OpenDrone-hw/OpenRX/images/openrx-gemini-back.png

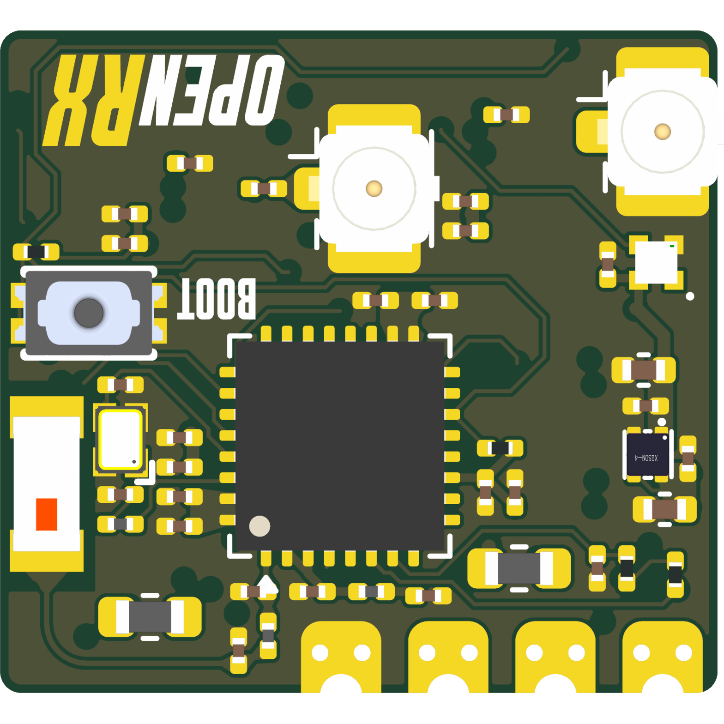
images/openrx-gemini-back.png
