OpenDrone-hw/OpenRX/images/openrx-lite-back.png

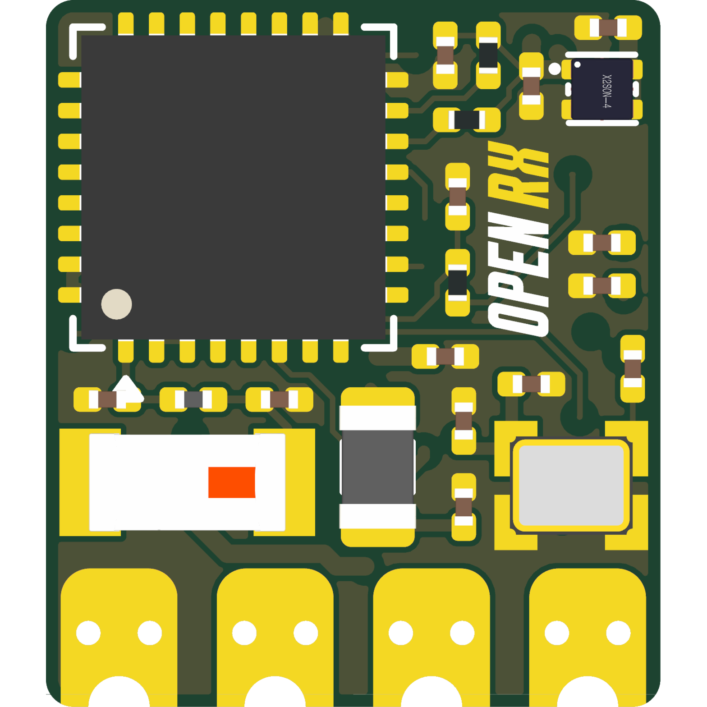
images/openrx-lite-back.png
