OpenDrone-hw/OpenRX/images/openrx-mono-back.png

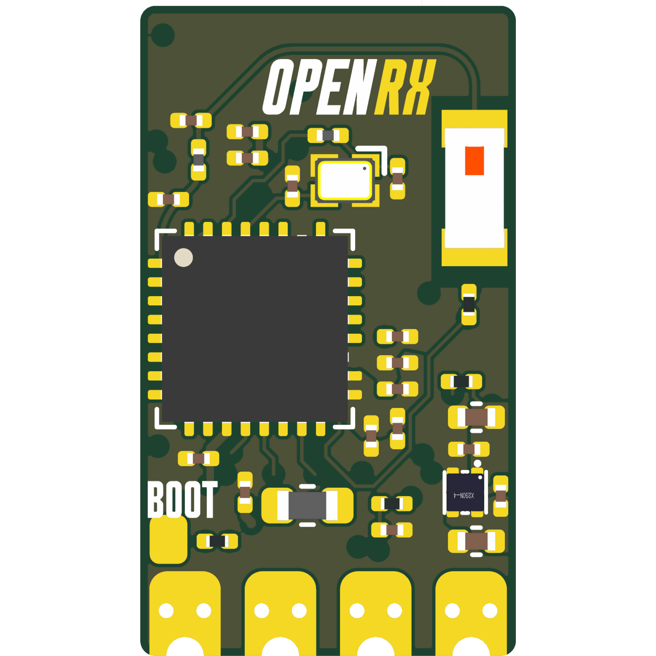
images/openrx-mono-back.png
