OpenDrone-hw/OpenRX/panel/OpenRX-panel-rev2.kicad_pcb

## KiCad design panel/OpenRX-panel-rev2.kicad_pcb (2026-09-19)

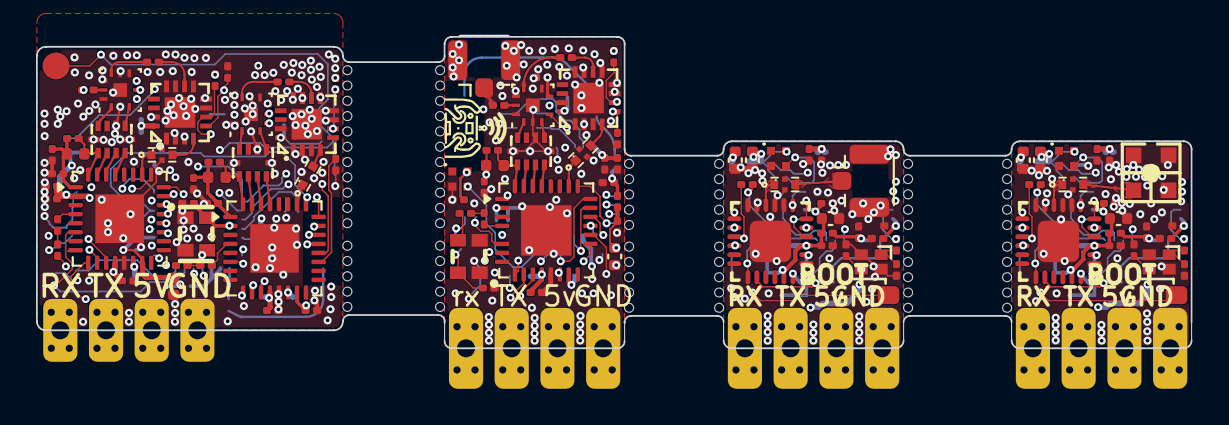
[picture p8: board OpenRX-panel-rev2.kicad_pcb from above]

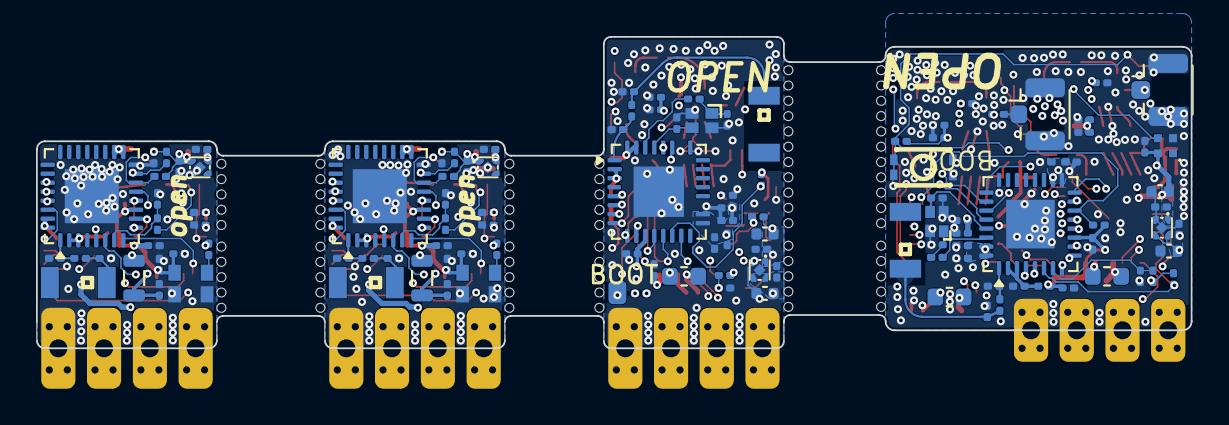
[picture p9: board OpenRX-panel-rev2.kicad_pcb from below]

Board: 6 copper layers, 64.2 x 17.3 mm, 241 parts (118 on the bottom side), 103 nets.

Parts:
AE1, AE101, AE201, AE301: 2450AT18A100E; ANT-SMD_L3.2-W1.6
AE302: 47948-0001; ANT-SMD_47948-0001
C1, C3, C101, C103, C201, C203, C301, C303: 15pF; C_0201_0603Metric
C2, C23, C24, C39, C42, C44, C102, C123, C124: 47p; C_0201_0603Metric
C4, C10, C17, C25, C27, C28, C31, C41, C104, C110, C117, C125, C127, C128, C131, C204, C210, C215, C223, C225, C228, C304, C310, C315, C323, C325, C328: 1uF; C_0201_0603Metric
C5, C6, C9, C12, C13, C14, C16, C35, C37, C105, C106, C109, C112, C113, C114, C116, C205, C206, C209, C212, C213, C214, C217, C305, C306, C309, C312, C313, C314, C317: 100nF; C_0201_0603Metric
C7, C34, C107: 10pF; C_0201_0603Metric
C8, C11, C18, C108, C111, C118, C208, C211, C216, C308, C311, C316: 10uF; C_0402_1005Metric
C15, C36, C115: 47pF; C_0201_0603Metric
C19, C33, C119: 2.2nF; C_0201_0603Metric
C20, C38, C120, C220, C320: 470nF; C_0201_0603Metric
C21, C40, C121: 220pF; C_0201_0603Metric
C22, C43, C122: 1n; C_0201_0603Metric
C26, C126, C224, C226, C227, C324, C326, C327: 10nF; C_0201_0603Metric
C29, C30, C129, C130, C221, C222, C321, C322: 1.2pF; C_0201_0603Metric
C219, C319: 1nF; C_0201_0603Metric
D1, D101, D201, D301: XL-1010RGBC-WS2812B; LED-SMD_4P-L1.0-W1.0-TL_XL-1010RGBC-WS2812B
FL1, FL2, FL101, FL201, FL301: 2450FM07D0034T; FILTER-SMD_4P-L1.0-W0.5-L
J1, J2, J101: Conn_Coaxial_Small; U.FL_Hirose_U.FL-R-SMT-1_Vertical
J201: Conn_Coaxial; U.FL_Hirose_U.FL-R-SMT-1_Vertical
L1, L6, L101: 10uH; L_0603_1608Metric
L2, L102, L201, L301: 24nH; L_0201_0603Metric
L3, L103, L203, L303: 2.0nH; L_0201_0603Metric
L4, L104, L202, L302: 2.5nH; L_0201_0603Metric
L5, L7, L105: 47nH; L_0402_1005Metric
L204, L304: 15uH; L_0805_2012Metric
OSC1, OSC101: OW7EL89CENUYO3YLC-32M; OSC-SMD_4P-L2.0-W1.6-BL_TXC_7Z
OSC201, OSC301: OW7EL89CENUNFAYLC-52M; OSC-SMD_4P-L2.0-W1.6-BL_TXC_7Z
R1, R10, R101: 200; R_0201_0603Metric
R2, R3, R4, R5, R102, R103, R104, R105, R202, R203, R204, R205, R302, R303, R304, R305: 10k; R_0201_0603Metric
R6, R9, R106: 220; R_0201_0603Metric
R7, R8, R11, R12, R107, R108: 100k; R_0201_0603Metric
T1, T2, T101: 0900PC16J0042001E; FILTER-SMD_10P-L2.0-W1.6-BL
TP1, TP101, TP201, TP301: RX; SolderPad_1.2x2.0mm
TP2, TP102, TP202, TP302: TX; SolderPad_1.2x2.0mm
TP3, TP103, TP203, TP303: 5V; SolderPad_1.2x2.0mm
TP4, TP104, TP204, TP304: GND; SolderPad_1.2x2.0mm
TP5: TestPoint; TestPoint_Pad_D1.5mm
TP105, TP205, TP305: BOOT; SolderPad_1.2x2.0mm
U1, U101, U201, U301: ESP32-C3; QFN-32-1EP_5x5mm_P0.5mm_EP3.7x3.7mm
U2, U102, U202, U302: TLV75533PDQNR; X2SON-4_L1.0-W1.0-P0.65-TL-EP
U3, U6, U103: LR1121IMLTRT; QFN-32-1EP_5x5mm_P0.5mm_EP3.7x3.7mm
U4, U7, U104: RFX2401C; QFN-16_L3.0-W3.0-P0.50-BL-EP1.7
U5, U8, U105: SKY13373-460LF; QFN-12_EP_2x2_Pitch0.5mm
U9: TS2306A 240GF MSM 9_C2976675; SW-SMD_4P-L3.0-W2.0-P0.85-LS3.5
U203, U303: SX1281IMLTRT; QFN-24_L4.0-W4.0-P0.50-TL-EP2.6
X1, X101, X201, X301: CJ17-400001010B20; CRYSTAL-SMD_4P-L1.6-W1.2-BL

Connections:
+3V3: C4.1, C5.1, C6.1, C9.1, C11.1, C12.1, C13.2, C14.1, C15.1, C16.1, C17.1, C18.1, C21.1, C22.1, C26.1, C27.1, C31.1, C35.1, C36.1, C37.1, C40.1, C41.1, C43.1, C104.1, C105.1, C106.1, C109.1, C111.1, C112.1, C113.2, C114.1, C115.1, C116.1, C117.1, C118.1, C121.1, C122.1, C126.1, C127.1, C131.1, C204.1, C205.1, C206.1, C209.1, C211.1, C212.1, C213.1, C214.1, C215.1, C216.1, C217.1, C223.1, C224.1, C304.1, C305.1, C306.1, C309.1, C311.1, C312.1, C313.1, C314.1, C315.1, C316.1, C317.1, C323.1, C324.1, D1.2 (VDD), D101.2 (VDD), D201.2 (VDD), D301.2 (VDD), L3.2, L103.2, L203.2, L303.2, OSC1.4 (VDD), OSC101.4 (VDD), OSC201.4 (VDD), OSC301.4 (VDD), R2.1, R3.1, R4.1, R5.2, R8.1, R12.1, R102.1, R103.1, R104.1, R105.2, R108.1, R202.1, R203.1, R204.1, R205.2, R302.1, R303.1, R304.1, R305.2, U1.11 (VDD3P3_RTC), U1.17 (VDD3P3_CPU), U1.18 (VDD_SPI), U1.31 (VDDA), U1.32 (VDDA), U2.1 (OUT), U3.2 (VBAT_RF), U3.15 (VBAT), U4.16 (VDD), U5.6 (VDD), U6.2 (VBAT_RF), U6.15 (VBAT), U7.16 (VDD), U8.6 (VDD), U101.11 (VDD3P3_RTC), U101.17 (VDD3P3_CPU), U101.18 (VDD_SPI), U101.31 (VDDA), U101.32 (VDDA), U102.1 (OUT), U103.2 (VBAT_RF), U103.15 (VBAT), U104.16 (VDD), U105.6 (VDD), U201.11 (VDD3P3_RTC), U201.17 (VDD3P3_CPU), U201.18 (VDD_SPI), U201.31 (VDDA), U201.32 (VDDA), U202.1 (OUT), U203.11 (VBAT_IO), U203.15 (VBAT), U301.11 (VDD3P3_RTC), U301.17 (VDD3P3_CPU), U301.18 (VDD_SPI), U301.31 (VDDA), U301.32 (VDDA), U302.1 (OUT), U303.11 (VBAT_IO), U303.15 (VBAT)
+5V: C8.1, C10.1, C108.1, C110.1, C208.1, C210.1, C308.1, C310.1, TP3.1 (1_1), TP103.1 (1_1), TP203.1 (1_1), TP303.1 (1_1), U2.3 (EN), U2.4 (IN), U102.3 (EN), U102.4 (IN), U202.3 (EN), U202.4 (IN), U302.3 (EN), U302.4 (IN)
/Clock/TCXO_Out: C7.2, C34.2, OSC1.3 (OutPut)
/ESP32-C3 + LR1121 Mono/BOOT: R104.2, TP105.1 (1_1), U101.15 (GPIO9)
/ESP32-C3 + LR1121 Mono/BUSY: U101.8 (GPIO3), U103.25 (DIO0/BUSY)
/ESP32-C3 + LR1121 Mono/CHIP_EN: C128.1, R105.1, U101.7 (CHIP_EN)
/ESP32-C3 + LR1121 Mono/CTRL1: U103.11 (DIO7), U105.4 (V1)
/ESP32-C3 + LR1121 Mono/CTRL2: U103.10 (DIO8), U105.5 (V2)
/ESP32-C3 + LR1121 Mono/DIO1: U101.5 (XTAL_32K_N), U103.9 (DIO9)
/ESP32-C3 + LR1121 Mono/LED: D101.4 (DIN), R103.2, U101.14 (GPIO8)
/ESP32-C3 + LR1121 Mono/MISO: U101.10 (MTDI), U103.21 (DIO4)
/ESP32-C3 + LR1121 Mono/MOSI: U101.9 (MTMS), U103.22 (DIO3)
/ESP32-C3 + LR1121 Mono/NSS: U101.13 (MTDO), U103.24 (DIO1)
/ESP32-C3 + LR1121 Mono/RST: R102.2, U101.6 (GPIO2), U103.6 (NRESET)
/ESP32-C3 + LR1121 Mono/RXEN24: R108.2, U103.20 (DIO5), U104.6 (RXEN)
/ESP32-C3 + LR1121 Mono/SCK: U101.12 (MTCK), U103.23 (DIO2)
/ESP32-C3 + LR1121 Mono/TXEN24: R107.2, U103.19 (DIO6), U104.5 (TXEN)
/ESP32-C3 + LR1121 Mono/VR_PA: C102.1, C119.1, L105.1, R101.1, U103.1 (VR_PA)
/ESP32-C3 + LR1121 Mono/WIFI: AE101.1, C130.1, L104.1
/ESP32-C3 + LR1121 Mono/XTAL_N: C103.1, U101.29 (XTAL_N), X101.3
/ESP32-C3 + LR1121 Mono/XTAL_P: L102.2, U101.30 (XTAL_P)
/ESP32-C3 + SX1281 Core (UFL)/BOOT: R204.2, R304.2, TP205.1 (1_1), TP305.1 (1_1), U201.15 (GPIO9), U301.15 (GPIO9)
/ESP32-C3 + SX1281 Core (UFL)/BUSY: U201.8 (GPIO3), U203.7 (BUSY), U301.8 (GPIO3), U303.7 (BUSY)
/ESP32-C3 + SX1281 Core (UFL)/CHIP_EN: C228.1, C328.1, R205.1, R305.1, U201.7 (CHIP_EN), U301.7 (CHIP_EN)
/ESP32-C3 + SX1281 Core (UFL)/DIO1: U201.5 (XTAL_32K_N), U203.8 (DIO1), U301.5 (XTAL_32K_N), U303.8 (DIO1)
/ESP32-C3 + SX1281 Core (UFL)/LED: D201.4 (DIN), D301.4 (DIN), R203.2, R303.2, U201.14 (GPIO8), U301.14 (GPIO8)
/ESP32-C3 + SX1281 Core (UFL)/MISO: U201.10 (MTDI), U203.16 (MISO_TX), U301.10 (MTDI), U303.16 (MISO_TX)
/ESP32-C3 + SX1281 Core (UFL)/MOSI: U201.9 (MTMS), U203.17 (MOSI_RX), U301.9 (MTMS), U303.17 (MOSI_RX)
/ESP32-C3 + SX1281 Core (UFL)/NSS: U201.13 (MTDO), U203.19 (NSS_CTS), U301.13 (MTDO), U303.19 (NSS_CTS)
/ESP32-C3 + SX1281 Core (UFL)/RST: R202.2, R302.2, U201.6 (GPIO2), U203.3 (NRESET), U301.6 (GPIO2), U303.3 (NRESET)
/ESP32-C3 + SX1281 Core (UFL)/SCK: U201.12 (MTCK), U203.18 (SCK_RTSN), U301.12 (MTCK), U303.18 (SCK_RTSN)
/ESP32-C3 + SX1281 Core (UFL)/WIFI: AE201.1, AE301.1, C221.1, C321.1, L202.1, L302.1
/ESP32-C3 + SX1281 Core (UFL)/XTAL_N: C203.1, C303.1, U201.29 (XTAL_N), U301.29 (XTAL_N), X201.3, X301.3
/ESP32-C3 + SX1281 Core (UFL)/XTAL_P: L201.2, L301.2, U201.30 (XTAL_P), U301.30 (XTAL_P)
/ESP32-C3/BOOT: R4.2, TP5.1 (1_1), U1.15 (GPIO9), U9.1
/ESP32-C3/BUSY_A: U1.8 (GPIO3), U3.25 (DIO0/BUSY)
/ESP32-C3/BUSY_B: R3.2, U1.14 (GPIO8), U6.25 (DIO0/BUSY)
/ESP32-C3/CHIP_EN: C28.1, R5.1, U1.7 (CHIP_EN)
/ESP32-C3/DIO1_A: U1.5 (XTAL_32K_N), U3.9 (DIO9)
/ESP32-C3/DIO1_B: U1.25 (GPIO18), U6.9 (DIO9)
/ESP32-C3/LED: D1.4 (DIN), U1.26 (GPIO19)
/ESP32-C3/MISO: U1.10 (MTDI), U3.21 (DIO4), U6.21 (DIO4)
/ESP32-C3/MOSI: U1.9 (MTMS), U3.22 (DIO3), U6.22 (DIO3)
/ESP32-C3/NSS_A: U1.4 (XTAL_32K_P), U3.24 (DIO1)
/ESP32-C3/NSS_B: U1.13 (MTDO), U6.24 (DIO1)
/ESP32-C3/RST_A: R2.2, U1.6 (GPIO2), U3.6 (NRESET)
/ESP32-C3/RST_B: U1.16 (GPIO10), U6.6 (NRESET)
/ESP32-C3/SCK: U1.12 (MTCK), U3.23 (DIO2), U6.23 (DIO2)
/ESP32-C3/WIFI: AE1.1, C30.1, L4.1
/ESP32-C3/XTAL_N: C3.1, U1.29 (XTAL_N), X1.3
/ESP32-C3/XTAL_P: L2.2, U1.30 (XTAL_P)
/LR1121_A/CTRL1: U3.11 (DIO7), U5.4 (V1)
/LR1121_A/CTRL2: U3.10 (DIO8), U5.5 (V2)
/LR1121_A/RXEN24: R8.2, U3.20 (DIO5), U4.6 (RXEN)
/LR1121_A/TXEN24: R7.2, U3.19 (DIO6), U4.5 (TXEN)
/LR1121_A/VR_PA: C2.1, C19.1, L5.1, R1.1, U3.1 (VR_PA)
/LR1121_B/CTRL1: U6.11 (DIO7), U8.4 (V1)
/LR1121_B/CTRL2: U6.10 (DIO8), U8.5 (V2)
/LR1121_B/RXEN24: R12.2, U6.20 (DIO5), U7.6 (RXEN)
/LR1121_B/TXEN24: R11.2, U6.19 (DIO6), U7.5 (TXEN)
/LR1121_B/VR_PA: C33.1, C39.1, L7.1, R10.1, U6.1 (VR_PA)
GND: AE302.1, AE302.2, AE302.4, C1.2, C2.2, C3.2, C4.2, C5.2, C6.2, C8.2, C9.2, C10.2, C11.2, C12.2, C13.1, C14.2, C15.2, C16.2, C17.2, C18.2, C19.2, C20.1, C21.2, C22.2, C25.2, C26.2, C27.2, C28.2, C29.2, C30.2, C31.2, C33.2, C35.2, C36.2, C37.2, C38.1, C39.2, C40.2, C41.2, C43.2, C101.2, C102.2, C103.2, C104.2, C105.2, C106.2, C108.2, C109.2, C110.2, C111.2, C112.2, C113.1, C114.2, C115.2, C116.2, C117.2, C118.2, C119.2, C120.1, C121.2, C122.2, C125.2, C126.2, C127.2, C128.2, C129.2, C130.2, C131.2, C201.2, C203.2, C204.2, C205.2, C206.2, C208.2, C209.2, C210.2, C211.2, C212.2, C213.2, C214.2, C215.2, C216.2, C217.2, C220.1, C221.2, C222.2, C223.2, C224.2, C225.2, C226.1, C227.2, C228.2, C301.2, C303.2, C304.2, C305.2, C306.2, C308.2, C309.2, C310.2, C311.2, C312.2, C313.2, C314.2, C315.2, C316.2, C317.2, C320.1, C321.2, C322.2, C323.2, C324.2, C325.2, C326.1, C327.2, C328.2, D1.3 (GND), D101.3 (GND), D201.3 (GND), D301.3 (GND), FL1.2 (GND), FL1.4 (GND), FL2.2 (GND), FL2.4 (GND), FL101.2 (GND), FL101.4 (GND), FL201.2 (GND), FL201.4 (GND), FL301.2 (GND), FL301.4 (GND), J1.2 (Ext), J2.2 (Ext), J101.2 (Ext), J201.2 (Ext), OSC1.1 (GND), OSC1.2 (GND), OSC101.1 (GND), OSC101.2 (GND), OSC201.1 (GND), OSC201.2 (GND), OSC301.1 (GND), OSC301.2 (GND), R7.1, R11.1, R107.1, T1.5 (GND), T1.7 (GND), T1.10 (GND), T2.5 (GND), T2.7 (GND), T2.10 (GND), T101.5 (GND), T101.7 (GND), T101.10 (GND), TP4.1 (1_1), TP104.1 (1_1), TP204.1 (1_1), TP304.1 (1_1), U1.33 (GND), U2.2 (GND), U2.5 (EP), U3.13 (GND), U3.33 (EP), U4.1 (GND), U4.2 (GND), U4.3 (GND), U4.7 (GND), U4.8 (GND), U4.9 (GND), U4.11 (GND), U4.12 (GND), U4.15 (GND), U4.17 (EP), U5.2 (GND), U5.7 (GND), U5.8 (GND), U5.10 (GND), U5.12 (GND), U5.13 (EP), U6.13 (GND), U6.33 (EP), U7.1 (GND), U7.2 (GND), U7.3 (GND), U7.7 (GND), U7.8 (GND), U7.9 (GND), U7.11 (GND), U7.12 (GND), U7.15 (GND), U7.17 (EP), U8.2 (GND), U8.7 (GND), U8.8 (GND), U8.10 (GND), U8.12 (GND), U8.13 (EP), U9.2, U101.33 (GND), U102.2 (GND), U102.5 (EP), U103.13 (GND), U103.33 (EP), U104.1 (GND), U104.2 (GND), U104.3 (GND), U104.7 (GND), U104.8 (GND), U104.9 (GND), U104.11 (GND), U104.12 (GND), U104.15 (GND), U104.17 (EP), U105.2 (GND), U105.7 (GND), U105.8 (GND), U105.10 (GND), U105.12 (GND), U105.13 (EP), U201.16 (GPIO10), U201.33 (GND), U202.2 (GND), U202.5 (EP), U203.13 (GND), U203.20 (GND), U203.21 (GND), U203.23 (GND), U203.24 (GND), U203.25 (EP), U301.16 (GPIO10), U301.33 (GND), U302.2 (GND), U302.5 (EP), U303.13 (GND), U303.20 (GND), U303.21 (GND), U303.23 (GND), U303.24 (GND), U303.25 (EP), X1.2 (GND), X1.4 (GND), X101.2 (GND), X101.4 (GND), X201.2 (GND), X201.4 (GND), X301.2 (GND), X301.4 (GND)
unnamed: C1.1, C101.1, C201.1, C301.1, L2.1, L102.1, L201.1, L301.1, X1.1, X101.1, X201.1, X301.1
unnamed: C7.1, C107.1, R6.1, R106.1
unnamed: C25.1, C125.1, C225.1, C325.1, L3.1, L103.1, L203.1, L303.1, U1.2 (VDD3P3), U1.3 (VDD3P3), U101.2 (VDD3P3), U101.3 (VDD3P3), U201.2 (VDD3P3), U201.3 (VDD3P3), U301.2 (VDD3P3), U301.3 (VDD3P3)
unnamed: C34.1, R9.1
unnamed: FL1.1 (IN), FL101.1 (IN), FL201.1 (IN), FL301.1 (IN), U3.26 (RFIO_HF), U103.26 (RFIO_HF), U203.22 (RFIO), U303.22 (RFIO)
unnamed: AE302.3, FL1.3 (OUT), FL101.3 (OUT), FL201.3 (OUT), FL301.3 (OUT), J201.1 (In), U4.4 (TXRX), U104.4 (TXRX)
unnamed: FL2.1 (IN), U6.26 (RFIO_HF)
unnamed: FL2.3 (OUT), U7.4 (TXRX)
unnamed: C24.2, C124.2, J1.1 (In), J101.1 (In)
unnamed: C44.2, J2.1 (In)
unnamed: C107.2, OSC101.3 (OutPut)
unnamed: C219.1, C319.1, OSC201.3 (Out_Put), OSC301.3 (Out_Put)
unnamed: T1.4 (RFI_N_LFO), T101.4 (RFI_N_LFO), U3.29 (RFI_N_LF0), U103.29 (RFI_N_LF0)
unnamed: T1.3 (RFI_P_LFO), T101.3 (RFI_P_LFO), U3.30 (RFI_P_LF0), U103.30 (RFI_P_LF0)
unnamed: L5.2, L105.2, R1.2, R101.2, T1.1 (RFO_HP_LF), T101.1 (RFO_HP_LF), U3.32 (RFO_HP_LF), U103.32 (RFO_HP_LF)
unnamed: T1.2 (RFO_LP_LF), T101.2 (RFO_LP_LF), U3.31 (RFO_LP_LF), U103.31 (RFO_LP_LF)
unnamed: T1.6 (RX), T101.6 (RX), U5.3 (J3), U105.3 (J3)
unnamed: T1.9 (TX_HP), T101.9 (TX_HP), U5.1 (J1), U105.1 (J1)
unnamed: T2.4 (RFI_N_LFO), U6.29 (RFI_N_LF0)
unnamed: T2.3 (RFI_P_LFO), U6.30 (RFI_P_LF0)
unnamed: L7.2, R10.2, T2.1 (RFO_HP_LF), U6.32 (RFO_HP_LF)
unnamed: T2.2 (RFO_LP_LF), U6.31 (RFO_LP_LF)
unnamed: T2.6 (RX), U8.3 (J3)
unnamed: T2.9 (TX_HP), U8.1 (J1)
unnamed: C29.1, C129.1, C222.1, C322.1, L4.2, L104.2, L202.2, L302.2, U1.1 (LNA_IN), U101.1 (LNA_IN), U201.1 (LNA_IN), U301.1 (LNA_IN)
unnamed: TP1.1 (1_1), TP101.1 (1_1), TP201.1 (1_1), TP301.1 (1_1), U1.27 (U0RXD), U101.27 (U0RXD), U201.27 (U0RXD), U301.27 (U0RXD)
unnamed: TP2.1 (1_1), TP102.1 (1_1), TP202.1 (1_1), TP302.1 (1_1), U1.28 (U0TXD), U101.28 (U0TXD), U201.28 (U0TXD), U301.28 (U0TXD)
unnamed: C220.2, C226.2, C320.2, C326.2, L204.1, L304.1, U203.2 (VDD_IN), U203.12 (DCC_FB), U303.2 (VDD_IN), U303.12 (DCC_FB)
unnamed: L1.1, L101.1, L204.2, L304.2, U3.14 (DCC_SW), U103.14 (DCC_SW), U203.14 (DCC_SW), U303.14 (DCC_SW)
unnamed: C20.2, C120.2, L1.2, L101.2, U3.12 (VREG), U103.12 (VREG)
unnamed: C227.1, C327.1, U203.1 (VR_PA), U303.1 (VR_PA)
unnamed: C219.2, C319.2, R6.2, R106.2, U3.4 (XTA), U103.4 (XTA), U203.4 (XTA), U303.4 (XTA)
unnamed: C23.1, C123.1, U4.10 (ANT), U104.10 (ANT)
unnamed: C23.2, C123.2, U5.9 (J2), U105.9 (J2)
unnamed: C24.1, C124.1, U5.11 (RFC), U105.11 (RFC)
unnamed: L6.1, U6.14 (DCC_SW)
unnamed: C38.2, L6.2, U6.12 (VREG)
unnamed: R9.2, U6.4 (XTA)
unnamed: C42.1, U7.10 (ANT)
unnamed: C42.2, U8.9 (J2)
unnamed: C44.1, U8.11 (RFC)
