OpenDrone-hw/OpenRX/(commit log)

2026-08-04 chore: wire shared Incutec KiCad library
    Adds incutec-hw/KiCad-Library as submodule at libs/KiCad-Library, pinned
    to the feat/complete-library build. Project lib tables gain the Incutec
    sym+fp entries via ${KIPRJMOD} relative paths. Existing local libraries
    untouched (frozen, see the library repo MANIFEST).
2026-08-04 chore: bump KiCad-Library submodule pin
2026-08-05 shared: refresh QFN-12/QFN-16 footprints, add RFX2401C 3D models
    Footprint editor resave of the two QFN footprints and new
    RFX2401C QFN-16 EP1.7 step/wrl models referenced by Mono and Gemini.
2026-08-05 OpenRX-Mono: PCB doc properties, 3D model fixes, target update, renders
    Board file gains DOC_* properties and corrected 3D model references
    (RFX2401C EP1.7, QFN-12 BL). ELRS target: corrected LR1121 RF switch
    control table, enable radio DCDC, WS2812 RGB LED instead of plain LED.
    Re-rendered README images.
    [OpenRX-Mono.kicad_pcb]
2026-08-05 OpenRX-Gemini: PCB doc properties, 3D model fixes, target update, renders
    Board file gains DOC_* properties and corrected 3D model references.
    ELRS target: corrected LR1121 RF switch control table, enable radio
    DCDC. Re-rendered README images.
    [OpenRX-Gemini.kicad_pcb]
2026-08-05 Lite/Lite-UFL: ELRS target pin remap and RGB LED
    Corrected SX1281 SPI pin map (miso/mosi/sck/dio1/nss) and switched
    from plain LED on GPIO10 to WS2812 RGB on GPIO8, matching the boards.
2026-08-05 docs: adopt OpenDrone repo standard
    README restructured to the standard section order; deep antenna, pad,
    pin-map, and firmware-target detail relocated to a new family DESIGN.md.
    Per-variant DESIGN.md files reconciled against the committed schematics,
    PCBs, and ELRS target JSON: SKY13373-460LF (not SKY13414), current
    radio_rfsw_ctrl values, real Gemini sheet hierarchy and refdes, Lite
    DESIGN.md no longer a copy of the Lite-UFL one. Adds CONTRIBUTING.md,
    AGENTS.md, CHANGELOG.md.
    Fact-check fixes: board sizes at Edge.Cuts centerline, KiCad 10 (not
    9/10), library claim corrected to OpenRX-Shared + Incutec submodule +
    embedded stock footprints, ELRS targets described as in-repo (not
    upstream),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
2026-08-05 chore: track per-variant Fabrication Toolkit config
2026-08-05 Fix archived legacy lib tables: correct shared lib relative URIs
    The OpenRX-900, OpenRX-Nano, and OpenRX-PWM projects were moved into
    archive/legacy-projects/ without updating their sym-lib-table and
    fp-lib-table URIs. ${KIPRJMOD}/../shared/libs/ resolved to the
    nonexistent archive/legacy-projects/shared/libs/. Corrected to
    ${KIPRJMOD}/../../../shared/libs/ which resolves to the real
    shared/libs/ at the repo root. Verified all six URIs resolve in a
    clean clone.
2026-08-05 changed 3.3V supply on clocks, added text, enlarged pads
    [OpenRX-Gemini.kicad_pcb, OpenRX-Gemini.kicad_sch, OpenRX-Lite-UFL.kicad_pcb, OpenRX-Lite-UFL.kicad_sch, OpenRX-Lite.kicad_pcb, OpenRX-Mono.kicad_pcb, OpenRX-Mono.kicad_sch, clock.kicad_sch]
2026-08-06 Rewrite CONTRIBUTING for humans: file locking, render proof, sign-off
    KiCad files cannot be merged, so the doc now leads with claiming files via
    git lfs lock and issue-first discussion, the convention used by LumenPnP and
    Ultimate Hacking Keyboard. Adds .gitattributes marking design files lockable.
    Drops the internal documentation-style rule that meant nothing to contributors.
2026-08-06 Untrack the bench flashing guide
    It documents an internal bench setup and points at a local-only ExpressLRS
    fork, so it is not usable by anyone cloning the repo. Per-board flashing
    guides get written after bringup. File stays on disk.
2026-08-06 Fix contradictions and duplicated information
    Contradictions:
    - Restore shared/libs/OpenRX-Shared.kicad_sym, dropped by accident in 5cd885c.
    All 7 sym-lib-tables point at it and the schematics carry 20 OpenRX-Shared:
    lib_ids, so a fresh clone could not edit or place any symbol. Restored
    byte-exact from 5cd885c^.
    - README board sizes now match Edge.Cuts: Lite and Lite-UFL 10.0 x 11.5 mm,
    Mono 10.0 x 17.3 mm. Gemini was already correct at 17.0 x 15.7 mm.
    - Remove the nine dead FLASHING.md links. The file is untracked and gitignored.
    Facts that only lived behind those links are inlined: the LR1121 DIO5-DIO8 to
    RFX2401C/SKY13373 mapping, the ExpressLRS 3.5.0 minimum, and the Mono/Gem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
    [lcsc-live-check.tsv, old-OpenRX-all.csv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]
2026-08-06 Restore Bastian's deletion of OpenRX-Shared.kicad_sym
    An automated pass re-added this file to resolve dangling sym-lib-table
    references. It was deleted deliberately in 5cd885c, so the re-add is reverted.
    The dangling references are real and remain: five sym-lib-table entries point
    at this path and the Mono and Gemini schematics carry 158 OpenRX-Shared
    symbol references. The schematics still open, because KiCad embeds every used
    symbol in the .kicad_sch. Whether the fix is to restore the library or finish
    migrating those symbols to the Incutec library is Bastian's call.
2026-08-06 Local libraries are the working default again
    New parts go into this repo's local libraries. KiCad-Library becomes a mirror
    of parts we already use or stock, worth checking first because a hit means we
    have sourced it before. Promotion into it is a separate step.
2026-08-11 update all RXs rev2 with fab files
    [OpenRX-Gemini-B_Cu.gbr, OpenRX-Gemini-B_Mask.gbr, OpenRX-Gemini-B_Paste.gbr, OpenRX-Gemini-B_Silkscreen.gbr, OpenRX-Gemini-Edge_Cuts.gbr, OpenRX-Gemini-F_Cu.gbr, OpenRX-Gemini-F_Mask.gbr, OpenRX-Gemini-F_Paste.gbr]
2026-08-12 Bump KiCad-Library submodule to a95b8fc
    The pointer was 23 commits behind. Most relevant: the shared library now
    carries QFN-16_L3.0-W3.0-H0.9-P0.50.step/.wrl, which these boards reference on
    the RFX2401C position. Without the bump that model resolves to nothing and the
    Gemini and Mono render with a hole where the part should be.
2026-08-12 Restore the QFN-12 3D model on the Mono SKY13373
    U5 carried no 3D model reference at all, so it rendered as nothing in the 3D
    viewer with no error to explain it. The library was never at fault:
    OpenRX-Shared.pretty/QFN-12_EP_2x2_Pitch0.5mm.kicad_mod already carries the
    model, it was the copy embedded in the board that lacked it.
    This restores the part of 68d07bb that was dropped when PR #19 was closed as
    superseded by #23. #23 only carried the two documentation commits, so the PCB
    half was lost. The RFX2401C model choice from that commit is deliberately left
    out, it remains an open decision against Bastian's generic QFN-16.
    Model reference only. Footprint, pad, segment, via, zone and net c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
    [OpenRX-Mono.kicad_pcb]
2026-08-12 Fix the RFX2401C 3D model on the Gemini variant boards
    The RFX2401C instances pointed at QFN-16_L3.0-W3.0-H0.9-P0.50.wrl with an
    offset of (-951.61, 821.31, 0), so the body rendered roughly a metre off the
    board and the land looked bare in the 3D viewer. Repointed at the RFX2401C
    model the library footprint specifies, with a zero offset, keeping the 270
    degree rotation.
    Also adds the QFN-12 model to the SKY13373 instances on these two variants,
    matching the fix already applied to Gemini and Mono.
    These boards now agree with
    OpenRX-Shared.pretty/QFN-16_L3.0-W3.0-P0.50-BL-EP1.7.kicad_mod, which always
    carried the correct model and offset. Update Footprints from Library will now
    preserve this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
    [OpenRX-Gemini-sameside.kicad_pcb, OpenRX-all.kicad_pcb]
2026-08-12 Add the ExpressLRS logo footprint to the shared library
    Graphics only, no pads, generated by bitmap2component. Marked board_only,
    exclude_from_pos_files and exclude_from_bom, so it stays out of the CPL and the
    BOM. Carries artwork on both F.SilkS and F.Cu; drop the F.Cu polygons after
    placing if silkscreen alone is wanted.
2026-08-12 Rev 2 board work: routing optimisations, logo placement, 3D model fixes
    Routing reworked on Lite (segments 313 to 256, vias 60 to 89), Lite-UFL
    (317 to 269, 61 to 85) and Gemini (682 to 688, 196 to 243). ExpressLRS logo
    placed on Mono.
    3D model fixes on Gemini and Mono:
    - RFX2401C (U4, U7) pointed at QFN-16_L3.0-W3.0-H0.9-P0.50.wrl with an offset
    of (-951.61, 821.31, 0), so the body rendered about a metre off the board and
    the land looked bare in the viewer. Repointed at the RFX2401C model that
    OpenRX-Shared.pretty/QFN-16_L3.0-W3.0-P0.50-BL-EP1.7.kicad_mod specifies,
    offset zeroed, 270 degree rotation kept.
    - SKY13373 (U5, U8) carried no model reference at all. Added, matching the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
    [OpenRX-Gemini.kicad_pcb, OpenRX-Lite-UFL.kicad_pcb, OpenRX-Lite.kicad_pcb, OpenRX-Mono.kicad_pcb]
2026-08-13 Standardise: six design docs into one AGENTS.md, trimmed README (#26)
    Adopts the org-wide shape for a multi-variant repo. The root DESIGN.md and the
    four per-variant DESIGN.md files become a single AGENTS.md: the family circuit,
    antennas, pad map, pin map and firmware targets once, then a section per
    variant. Cross-references between the old files become in-document anchors, all
    of which resolve.
    Every variant gains a .kicad_dru carrying the canonical block. Lite and
    Lite-UFL had none at all; Mono and Gemini had a single rule conditioned on a
    "50Ohm" netclass that no project in the org defines, so it could never fire.
    README drops the repository layout, build commands and per-variant detai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
2026-08-13 README: standardised link row, specs from the shop, status badge (#28)
    Same shape in every board repo.
    Outbound links move out of prose into one badge row: status, shop, the product's
    Discord channel, its build video, and OSHWA where the board is certified. The
    status badge links to the stage ladder in the org CONTRIBUTING rather than
    describing the stage here.
    The specification table is synced from the product page on opendrone.be, which
    is the maintained copy for now. Long term this goes the other way.
    "In the line" points at opendrone.be instead of listing sibling repos by hand,
    since what pairs with what changes there first.
    Drops the JustFPV teardown line, now the video badge, and o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
2026-08-14 chore: bump KiCad-Library submodule pin to 8f8093b
2026-08-14 Normalise board setup to the line standard
    The canonical dru's copper-to-copper rule demanded 0.1 mm outer
    clearance against the 0.09 line standard stated in the same file,
    flooding DRC with false errors on standard-routed boards. Removed;
    the project-file floors gate this already. Rule floors set to the
    line standard where the routed board complies, verified by DRC:
    zero new violations.
2026-08-14 Drop the KiCad-Library submodule: nothing references it
    No symbol, footprint or 3D model in the design resolves through
    libs/KiCad-Library; every part is in the repo's local libraries. The
    submodule only cost --recursive clones and pin maintenance. Lib-table
    rows for the dead Incutec nickname removed so KiCad stops warning.
2026-08-14 Rev 3.1 working state: zone refills, fab option names, ordered sets
    Mono and Gemini PCB zone refills and priority renumbering, Lite-UFL J1
    LCSC field, fabrication-toolkit archive names per revision, the dated
    2026-08-06 production sets for Lite-UFL and Mono as the record of what
    was ordered, competitor RX catalogue, stale export STEPs deleted. The
    repo-specific .gitignore tail restores flashing/bringup notes and the
    firmware handoff bundle to local-only, plus regenerable dumps.
    [OpenRX-Gemini.kicad_pcb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]
2026-08-14 Track FLASHING.md, drop the legacy-projects archive from the tip
    FLASHING.md is the per-product flashing and debug reference; people
    cannot use the boards without it, so it is repo content, not a bench
    note. The five superseded designs (44 MB) stay in git history, which is
    what archives are; the tip carries current designs only.
    [OpenRX-900.kicad_pcb, OpenRX-900.kicad_sch, OpenRX-Duak.kicad_pcb, OpenRX-Nano.kicad_pcb, OpenRX-Nano.kicad_sch, OpenRX-PWM.kicad_pcb, OpenRX-PWM.kicad_sch, OpenRX.kicad_pcb]
2026-08-14 Rebuild E6 substitute STEP models from the trusted wrl geometry
    The .step files beside these .wrl models were different parts (USB-C
    3.5x oversized, etc), and the upstream LCSC .step is the same wrong
    file, so kicad-cli --subst-models shipped wrong geometry in every STEP
    export while the 3D viewer looked perfect. Rebuilt as tessellated STEP
    solids from the .wrl the viewer renders, via
    OpenDrone-Scripts/kicad/wrl_to_step.py: bbox and origin now match to
    0.000 mm. check_models reports zero E6, export unblocked.
    [OpenRX-Gemini.kicad_pcb, OpenRX-Lite.kicad_pcb, OpenRX-Mono.kicad_pcb]
2026-08-14 Fix the Gemini archive name typo: Gemeni -> Gemini_rev2
    Matches the Lite_rev2 / Mono_rev2 naming. Set re-exported headless,
    byte-identical BOM and positions to the misnamed set.
2026-08-14 Lite-UFL J1: LCSC C88374, no leading space, on board and schematic
    The schematic had ' C88374' with a leading space and the board had no
    LCSC field at all, so the U.FL connector silently dropped out of the
    fab BOM: check_export.py C3 caught it (bom 0 < sch 1). Schematic fixed
    by one-string replacement; board field added via the pcbnew API, styled
    like every other hidden LCSC field. Export re-run and verified.
    [OpenRX-Lite-UFL.kicad_pcb, esp32c3_sx1281_lite.kicad_sch]
2026-08-14 Rev 2 refresh prep: renders, schematic PDFs, revisions
    The committed board now matches the verified fab export exactly
    (check_export.py C1-C3 clean). Renders regenerated from it.
2026-08-15 docs: standardise AGENTS.md, complete spec table, fix flash targets
    AGENTS.md rebuilt on the org template and fact-checked against the design files. README spec table completed (telemetry power, dimensions, 1.0 mm PCB for all variants) and maintainer added. FLASHING.md build targets corrected to opendrone.rx_2400.lite / .lite_ufl. DOC text variables cleaned of em dashes.
2026-08-22 3D models: retarget to KiCad stock, fix placement
    Replaces easyeda2kicad 3D models with KiCad's own where a dimension-matched
    equivalent exists. The easyeda models run 20-100x denser for the same package
    and most carry the LCEDA watermark modelled as raised geometry, which renders
    on every CAD picture of the board and is not on the real part.
    Only the (model ...) reference, offset and rotation are touched. No footprint,
    pad, land pattern, net, placement or value is modified. Applied to the footprint
    LIBRARY and the boards together: fixing only the .pretty is invisible because
    each board carries its own footprint copy, and fixing only the .kicad_pcb is
    surface level because the next placemen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
    [OpenRX-Gemini.kicad_pcb, OpenRX-Lite-UFL.kicad_pcb, OpenRX-Lite.kicad_pcb, OpenRX-Mono.kicad_pcb, OpenRX-all.kicad_pcb]
2026-08-25 sch: standardise LCSC/Manufacturer/MPN fields across all variants
    Migrated LCSC part numbers out of variant-specific LCSC_Part fields into
    the standard LCSC field, and backfilled Manufacturer/MPN from the LCSC
    catalogue, on all four board variants (Gemini, Lite, Lite-UFL, Mono) and
    the shared ESP32-C3/SX1281 RX core sheet.
    kicad-skip reflowed each file on save, so the diffs are large but purely
    formatting; a structural S-expression diff and ERC re-run on all 12
    affected schematics (including the 4 unmodified top-level sheets) confirm
    only property values changed, no nets/placement/footprints touched.
    Known gap: L2/L3 in OpenRX-Gemini/esp32c3_lr1121_gemini.kicad_sch carry
    LCSC C1035, which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
    [clock.kicad_sch, esp32-c3.kicad_sch, esp32c3_lr1121_gemini.kicad_sch, esp32c3_lr1121_mono.kicad_sch, esp32c3_sx1281_lite.kicad_sch, esp32c3_sx1281_rx_core.kicad_sch, lr1121.kicad_sch]
2026-08-31 AGENTS.md: sync from the bench mirror rework (#45)
    Formatting repairs plus verified corrections from the 2026-08-31 bench
    session (fact-checked against datasheets, board READMEs and firmware
    sources). Details per file in OpenDrone-Testing commit 06034b3.
2026-09-01 chore: standardize OpenRX design assets
    [OpenRX-Gemini.kicad_pcb, OpenRX-Mono.kicad_pcb, OpenRX-all.kicad_pcb]
2026-09-01 Adopt shared KiCad datasheets
2026-09-01 Turn OpenRX into the receiver family hub
    [OpenRX-Gemini-B_Cu.gbr, OpenRX-Gemini-B_Mask.gbr, OpenRX-Gemini-B_Paste.gbr, OpenRX-Gemini-B_Silkscreen.gbr, OpenRX-Gemini-Edge_Cuts.gbr, OpenRX-Gemini-F_Cu.gbr, OpenRX-Gemini-F_Mask.gbr, OpenRX-Gemini-F_Paste.gbr]
2026-09-09 Add the OpenRX production panel
    panel/ holds the four boards merged onto one strip for combined
    fabrication and assembly, which is what PCBGOGO quotes against. It is
    manufacturing geometry rather than a design source, and it belongs to no
    single board repository because it contains all four.
    References are made unique across the strip in blocks of 100 per board,
    so a panel reference maps back to its board by integer division, and
    part fields are synced from the four boards so the panel BOM equals
    their sum exactly. The refmap is generated alongside the board.
    The superseded pre-split export is kept on disk, ignored and marked not
    to be sent; its placement file does not match this panel.
    C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
    [OpenRX-panel-rev2.kicad_pcb, OpenRX-panel-rev2_refmap.csv]
2026-09-09 Set the panel titleblock revision to rev2
    quote_pack.py syncs the titleblock from the release stem; recording it
    keeps the panel stable across exports.
    Claude-Session: https://claude.ai/code/session_01HXA6SP2VEuBZn7yMrez3es
    [OpenRX-panel-rev2.kicad_pcb]
2026-09-09 Fill in manufacturer and MPN across the panel
    Panel part fields were synced from the board footprints, which mostly
    carry only an LCSC code, so 36 of 40 lines in the panel BOM reached the
    supplier template with no manufacturer part number. They now come from
    the released board BOMs, where the schematic join resolved them.
    Only the bare test pads are left without a part number, which is correct.
    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
    [OpenRX-panel-rev2.kicad_pcb]
2026-09-24 docs: fix competitor catalog headline total to match table sum (#47)
    docs/competitor-rx-catalog.md headlined 55 total ESP32-C3 RX SKUs, but the
    six category tables (Gemini 10, Mono 24, Lite-with-FE 8, Lite-no-FE 7,
    Lite-True-Diversity 3, Lite-with-PWM 2) sum to 54, and the doc's own
    Convention summary already says "All 54 products". Changed the headline to
    54.
2026-11-11 docs(rules): kicad-skip cannot round-trip KiCad 10 schematics (#60)
    Syncs the shared Rules section from OpenDrone-hw/hardware-template (PR 16).
2026-11-12 Per-variant production boards: Mono and Gemini rev2.2, Lite and Lite-UFL rev2.3 (panel/single) (#61)
    One board per OpenRX variant for batch 2, where each variant is ordered in its own quantity and the fab arrays each design itself.
    | Variant | Board tag | Batch 2 qty | Note |
    |---|---|---|---|
    | Lite-UFL | `rev2.3` | 1,000 | includes the 1 Nov fix (OpenRX-Lite-UFL #11) and OSC1 DNP cleared (#13) |
    | Mono | `rev2.2` | 1,000 | same commit as the 4-in-1 panel |
    | Gemini | `rev2.2` | 500 | same commit as the 4-in-1 panel |
    | Lite | `rev2.3` | 250 | includes the 1 Nov fix (OpenRX-Lite #11) and OSC1 LCSC fields restored (#13) |
    Founder decision 12 Nov 2026: Lite and Lite-UFL include the 1 Nov fi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
2026-11-12 Drop the Lite and Lite-UFL singles: rev2.3 is released from the board repos (#62)
    | Board | Batch 2 source |
    |---|---|
    | Lite, Lite-UFL | board repo at tag `rev2.3` (titleblock rev2.3, 1 Nov fix, founder 12 Nov) |
    | Mono, Gemini | `panel/single` at `rev2.2` (unchanged) |
    The singles from #61 pinned the first rev2.3 tag, which moved one commit on to set the titleblock (OpenRX-Lite #14, OpenRX-Lite-UFL #14). Released from its own repository, a board is checked against its schematic (reference sync), which a merged single is not.
    Removed-knowledge: AGENTS.md:52-55 -> wrong: it described Lite and Lite-UFL singles at rev2.3 that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
